atomicra1n/lab-power-supply/images/enclosure.png

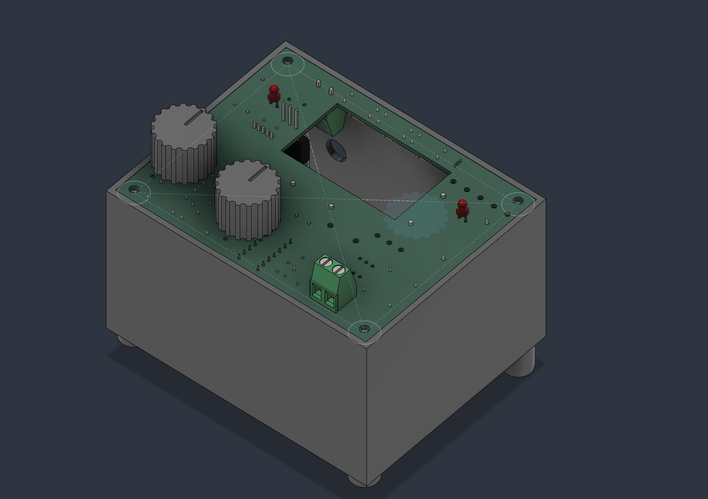
images/enclosure.png
