atomicra1n/lab-power-supply/images/pcb.png

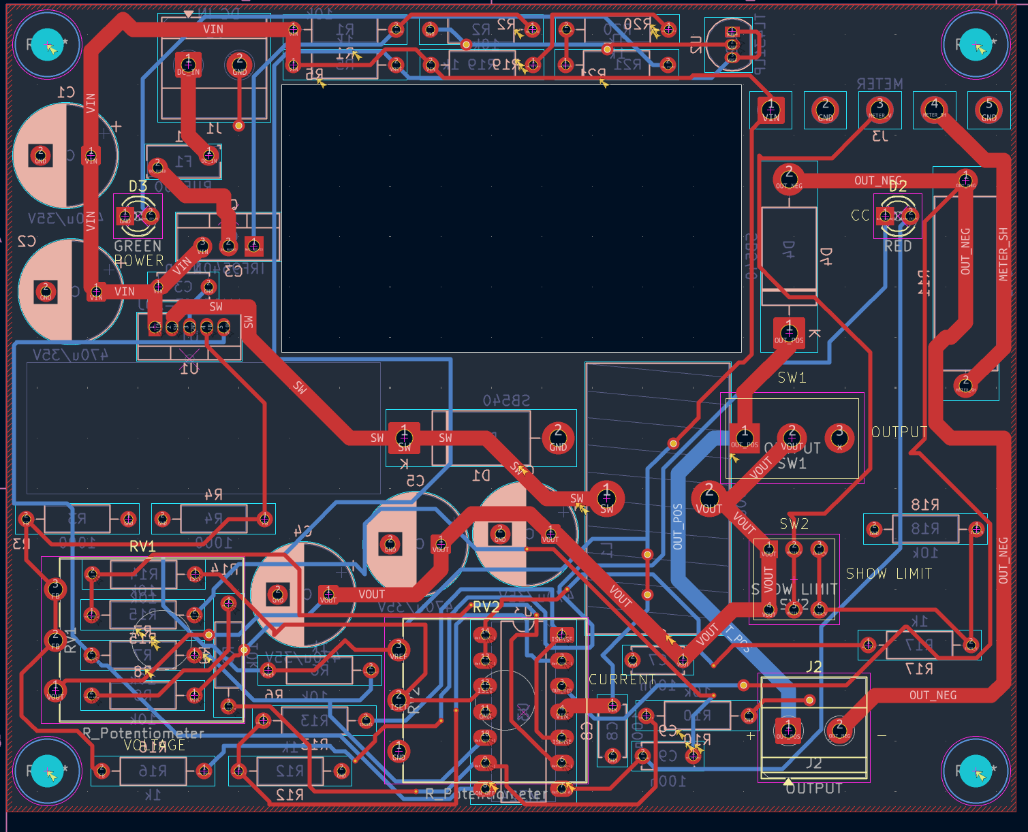
images/pcb.png
