atomicra1n/lab-power-supply/images/pcb_render_back.png

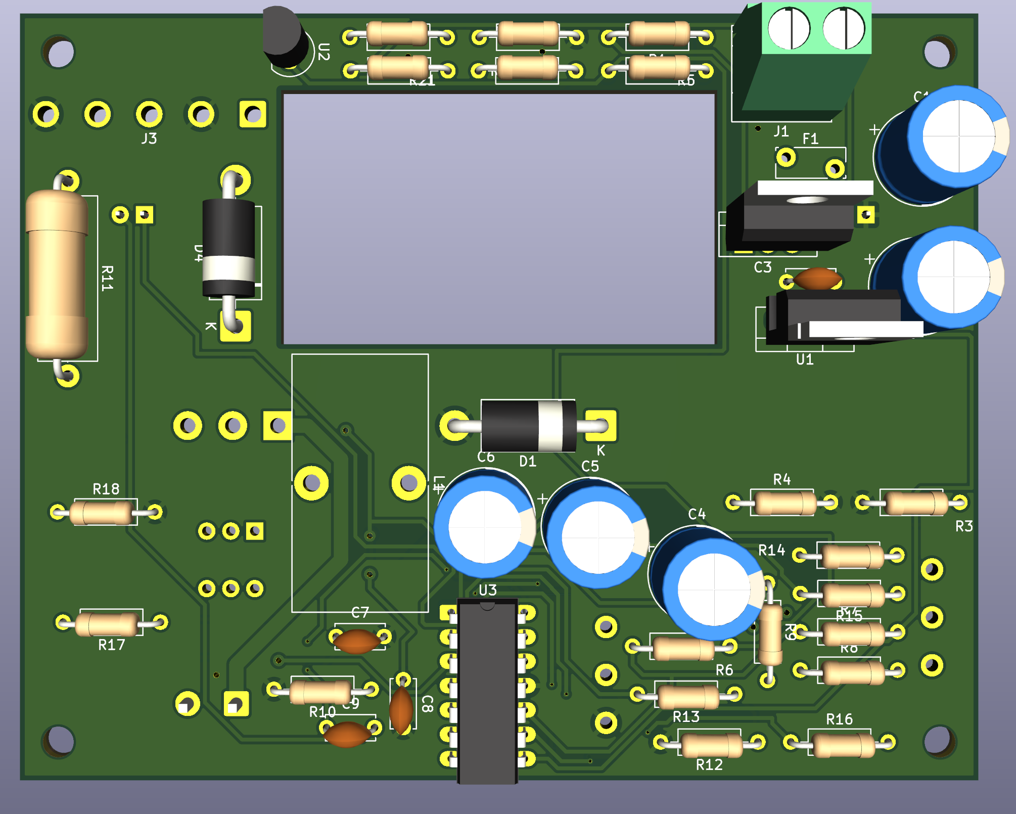
images/pcb_render_back.png
