atomicra1n/lab-power-supply/images/pcb_render_front.png

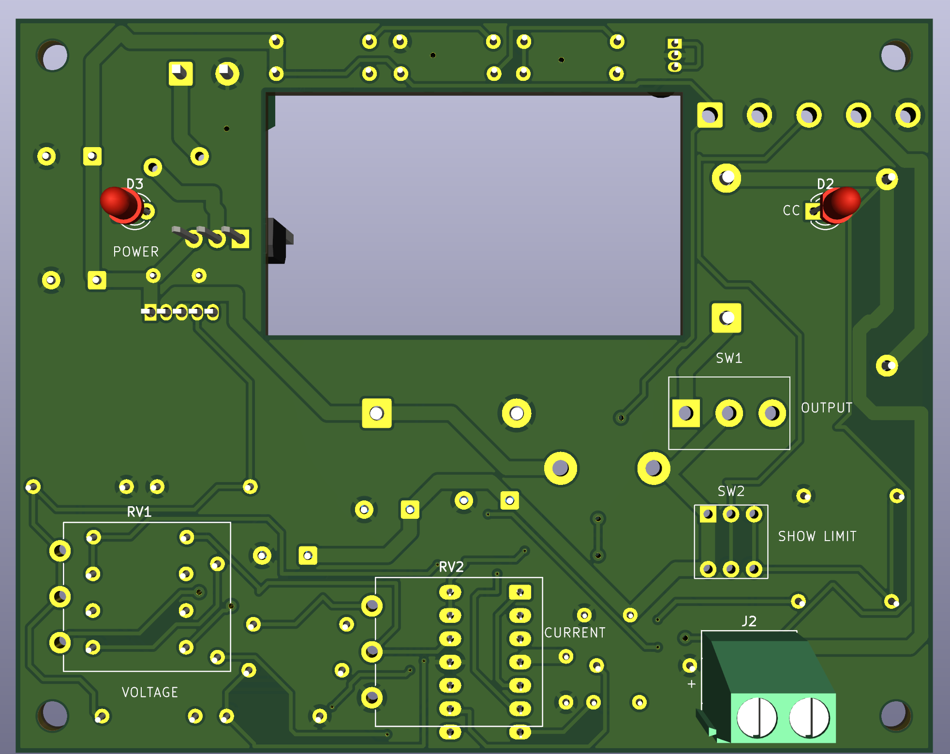
images/pcb_render_front.png
