atomicra1n/lab-power-supply/images/schematic.png

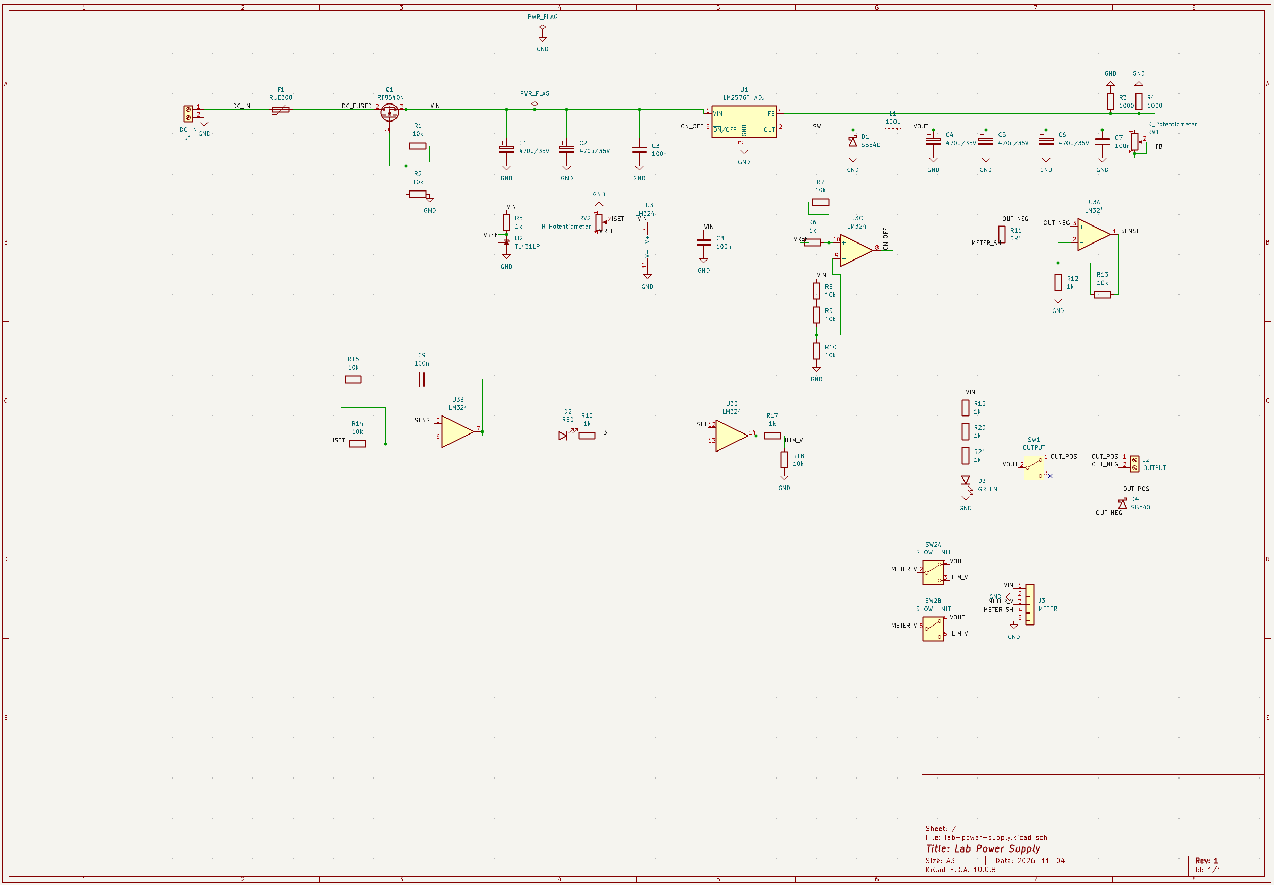
images/schematic.png
