atomicra1n/lab-power-supply/BOM.csv

Item | Qty | Supplier | Cost/item | Total Cost | link
TAEJIN-HTC LM2576T-ADJ | 1 | GM Electronic | $2.31 | $2.31 | https://www.gme.cz/v/1519044/taejin-htc-korea-lm2576t-adj-vykonovy-spinany-regulatorstep-down
TALEMA DPO-3.0-100 | 1 | GM Electronic | $3.07 | $3.07 | https://www.gme.cz/v/1494058/talema-dpo-30-100-tlumivka
SB540 YJ Schottky | 2 | GM Electronic | $0.45 | $0.90 | https://www.gme.cz/v/1514436/sb540-yj-schottkyho-dioda
V7143 BLACK heatsink | 1 | GM Electronic | $1.56 | $1.56 | https://www.gme.cz/v/1499787/v7143-black-chladic
INFINEON IRF9540NPBF | 1 | GM Electronic | $0.61 | $0.61 | https://www.gme.cz/v/1493222/infineon-irf9540npbf-unipolarni-tranzistor
TL431ACZ | 1 | GM Electronic | $0.28 | $0.28 | https://www.gme.cz/v/1493687/tl431acz
HITANO CE 470u/35V 10x16 | 5 | GM Electronic | $0.18 | $0.90 | https://www.gme.cz/v/1486880/hitano-ce-470u-35v-hit-ecr-10x16-rm5-bulk-elektrolyticky-kondenzator
CK 100n/50V X7R RM5,08 | 8 | GM Electronic | $0.09 | $0.72 | https://www.gme.cz/v/1520318/ck-100n-50v-x7r-rm508-10-keramicky-kondenzator
GYM/CYM RM 1k 0,6W 1% 0207 | 10 | GM Electronic | $0.09 | $0.90 | https://www.gme.cz/v/1486228/gym-cym-rm-1k-06w-1-0207-metalizovany-rezistor
GYM/CYM RM 10k 0,6W 1% 0207 | 10 | GM Electronic | $0.09 | $0.90 | https://www.gme.cz/v/1494150/gym-cym-rm-10k-06w-1-0207-metalizovany-rezistor
TEXAS INSTRUMENTS LM324N | 1 | GM Electronic | $0.42 | $0.42 | https://www.gme.cz/v/1490186/texas-instruments-lm324n
HITANO RD 0R1 3W 0617 | 4 | GM Electronic | $0.22 | $0.88 | https://www.gme.cz/v/1486965/hitano-rd-0r1-3w-5-0617-dratovy-rezistor
PC1623NBK010 10 kiloohm potentiometer | 2 | GM Electronic | $1.04 | $2.08 | https://www.gme.cz/v/1494596/pc1623nbk010-potenciometr
BRIGHT LED BL-B2141-L green | 1 | GM Electronic | $0.17 | $0.17 | https://www.gme.cz/v/1492964/bright-led-bl-b2141-l-led-3mm-zelena
BRIGHT LED BL-B5141-L red | 1 | GM Electronic | $0.17 | $0.17 | https://www.gme.cz/v/1492965/bright-led-bl-b5141-l-led-3mm-cervena
KLS 7-P8.0x8.0-0 button | 1 | GM Electronic | $0.25 | $0.25 | https://www.gme.cz/v/1500951/kls-7-p80x80-0-non-lock-tlacitko-do-dps-2-poly-onon
MTS-102-A2 toggle | 1 | GM Electronic | $0.66 | $0.66 | https://www.gme.cz/v/1501004/mts-102-a2-packovy-spinac
DEGSON DG301-5.0-02P | 2 | GM Electronic | $0.15 | $0.30 | https://www.gme.cz/v/1500295/degson-dg301-50-02p-13-00zh-svorkovnice-2pol-roztec-5mm-175a-250v-vstup-90-sroub
LITTELFUSE RUE300 | 1 | GM Electronic | $0.75 | $0.75 | https://www.gme.cz/v/1512378/littelfuse-rue300-vratna-pojistka-polyswitch
CREATALL CA-028-10A | 1 | GM Electronic | $3.73 | $3.73 | https://www.gme.cz/v/1518962/creatall-ca-028-10a-digitalni-panelovy-voltmetr-a-ampermetr
DS-026A DC jack 5.5/2.5 | 1 | GM Electronic | $1.04 | $1.04 | https://www.gme.cz/v/1498554/ds-026a-dc-konektor-55-25
WURTH SKM3X10 screw M3x10 | 5 | GM Electronic | $0.14 | $0.70 | https://www.gme.cz/v/1511747/wurth-skm3x10-ocelovy-sroub-m3x10mm-phillips-valcova-hlava-pozinkovany
WURTH SKM3K nut M3 | 1 | GM Electronic | $0.03 | $0.03 | https://www.gme.cz/v/1511808/wurth-skm3k-matice-m3
PCB manufacturing (5x) | 1 | JLCPCB | $4.00 | $4.00 | https://jlcpcb.com
Estimated total shipping | 1 |  |  | $11.00
