atomicra1n/lab-power-supply/cad/lab-power-supply-enclosure.step

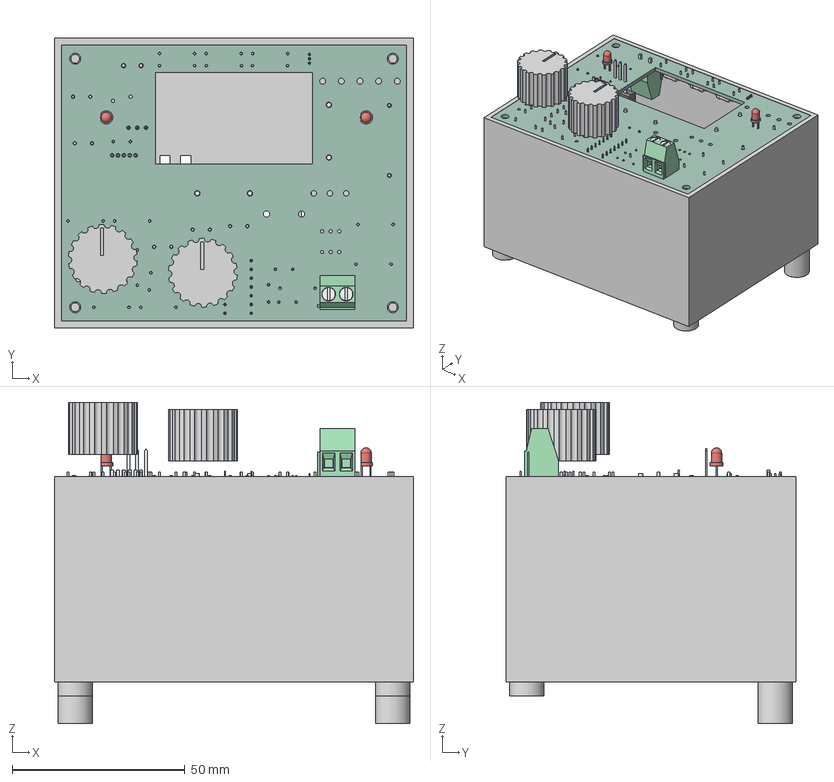
[picture p6: CAD file, 2026-11-07]
cad/lab-power-supply-enclosure.step
104.0 x 84.0 x 93.0 mm
