atomicra1n/lab-power-supply/stl/foot_12mm.stl

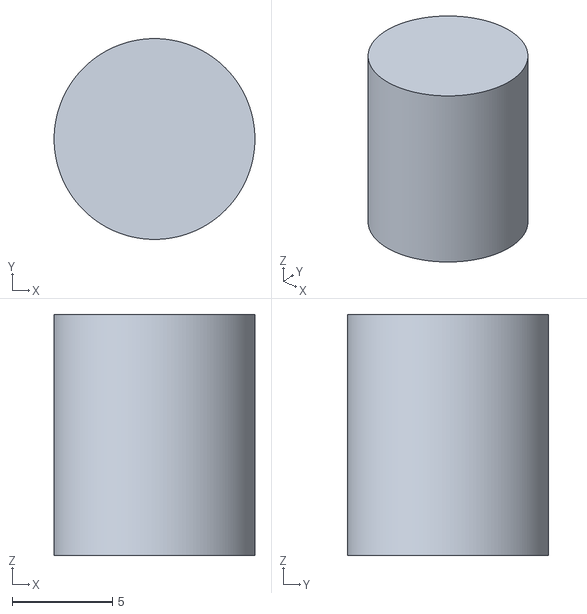
[picture p7: CAD file, 2026-11-07]
stl/foot_12mm.stl
10.00 x 10.00 x 12.0
