atomicra1n/lab-power-supply/stl/foot_4mm.stl

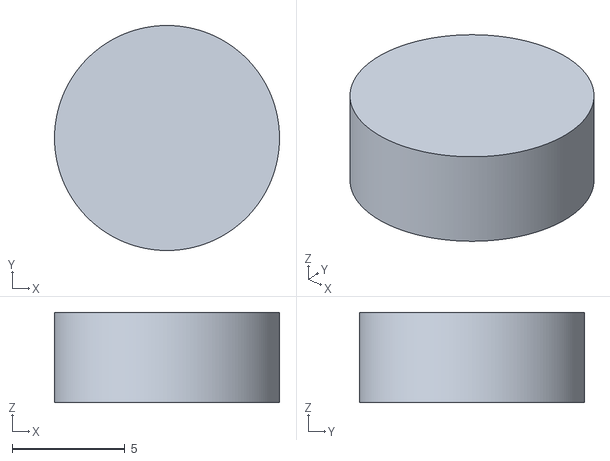
[picture p8: CAD file, 2026-11-07]
stl/foot_4mm.stl
10.0 x 10.0 x 4.00
