atomicra1n/lab-power-supply/stl/tray.stl

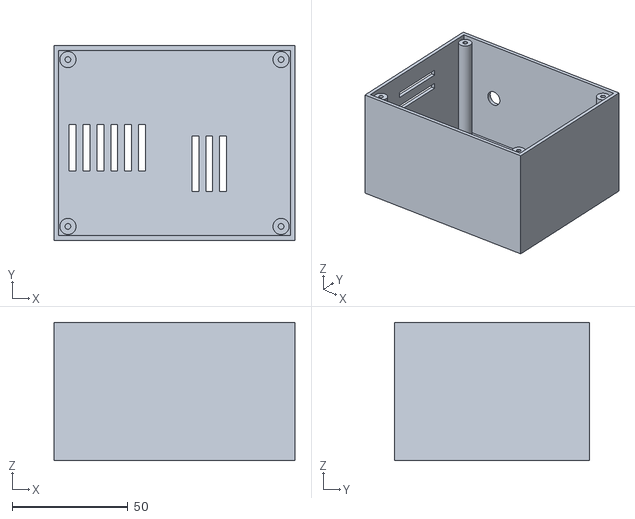
[picture p9: CAD file, 2026-11-07]
stl/tray.stl
104.0 x 84.0 x 59.6
