atomicra1n/lab-power-supply/stl/knob.stl

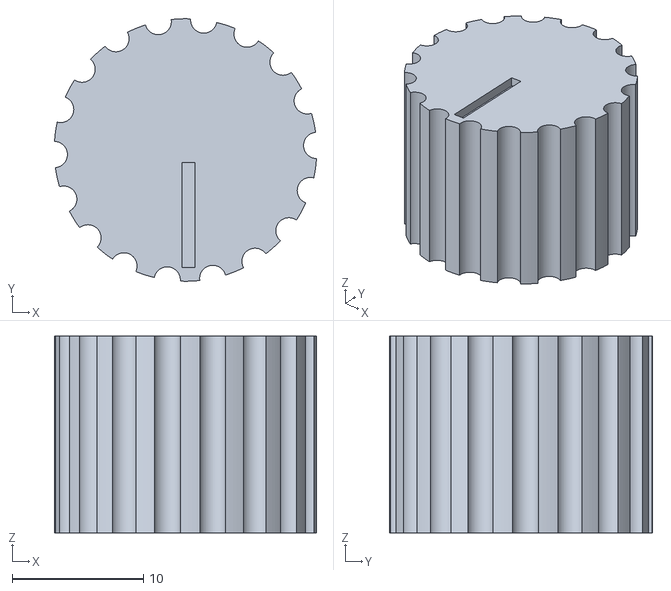
[picture p10: CAD file, 2026-11-07]
stl/knob.stl
20.0 x 20.0 x 15.0
