atomicra1n/lab-power-supply/(list of files, cad)

Other CAD files:
cad/lab-power-supply-enclosure.f3d
