atomicra1n/lab-power-supply/JOURNAL.md

# Lab Power Supply: devlog

<!-- Generated by Half Life from project vnvrcz1it7orpgph0o1aiyoc. Edits here are overwritten on the next sync. -->
<!-- Generated: 2026-11-07T19:35:36.796Z -->

> [!NOTE]
> This devlog is mirrored from [Half Life](https://halflife.hackclub.com) ([open the project](https://halflife.hackclub.com/projects/vnvrcz1it7orpgph0o1aiyoc)). Editing it here will not change the platform's copy, and the next sync overwrites this file.

> An adjustable power supply powered by a laptop charger. Has knobs for setting the voltage, current and a built-in meter for showing the output.

| Week | Tier | Hours logged | Entries |
| --- | --- | --- | --- |
| Week 5 | Tier 1 | 19h | 5 |

## Contents

1. [2026-11-05: # Nov 4: First work and schematic](#2026-11-05-nov-4-first-work-and-schematic)
2. [2026-11-05: # Nov 5: Finished schematic and footprints](#2026-11-05-nov-5-finished-schematic-and-footprints)
3. [2026-11-05: # Nov 5: Beginning PCB work](#2026-11-05-nov-5-beginning-pcb-work)
4. [2026-11-06: # Nov 6: Finishing the PCB](#2026-11-06-nov-6-finishing-the-pcb)
5. [2026-11-07: # Nov 7: CAD work](#2026-11-07-nov-7-cad-work)

## Design

### 2026-11-05: # Nov 4: First work and schematic

**4h**

# Nov 4: First work and schematic

Given that week 5 lets us build whatever we want, my brain immediately jumped to more nuclear related projects (I built some for week 1 and 4!), but then I reconsidered and thought - what would be genuinely useful to me?

I decided the answer was an adjustable power supply. It is a very handy thing to have for testing electronics or in general for work (I was recently reverse engineering a network switch and needed a  stable 3.3V source to dump the flash! Fun fact, a Raspberry Pi Pico can work, but it's amperage is very limited). First, I thought of how I would power said supply. I originally wanted USB, but it would get pricy and more complicated fast. So I decided to spare myself the pain and money and I found a Connect IT laptop charger that outputs around 18V on a 5.5/2.5mm barrel jack tip. I decided to use a LM2576T-ADJ buck converter to step it down while still being able to add current limiting that is adjustable. Given that lab supplies and their components are expensive, I decided this project would be fully analog with no microcontroller or firmware. That way, I can save money on the digital side of things and make the supply more powerful.

I started by going through GM Electronic (just like W3/4, it's my local electronics supplier) and picked out every part. The biggest issue like always is the fact that passive components have strict minimum order quantities, especially resistors (1 type of resistor = 10 pcs/2 Kč each, roughly 1$ total for 10). Resistors having a minimum would be bearable, but some components have a minimum much higher and the costs go up fast. I decided I would only use 1k and 10k resistors to save money on other types.

GM Electronic cart

One feature I was planning was undervoltage lockout to make sure that the regulator wouldn't try to run with an input too low. My original idea was using a TL431  as a comparator that would drive the ON and OFF pins of LM2576, but the datasheet of LM2576 sadly clearly says the ON and OFF pin needed to be below 1 volt for the regulator to turn on, and the TL431 can never get its cathode below 2V. To fix this, I removed the LM358P I originally planned for sensing current and replaced it with an LM324N.

With parts picked out and an idea of how the supply would work, I created the KiCad project, made a repo, structured it and started the schematic. For the input stage, I put a simple screw terminal from the DC jack, a RUE300 polyfuse for OCP and I also added reverse polarity protection (w/ IRF9540N).

Input

Next I put a LM2576T-ADJ buck converter. I used a TALEMA DPO-3.0-100 inductor and a SB540 Schottky catch diode. I needed a 500 ohm resistance for feedback, so I had to make it in parallel using my two 1k resistors. For undervoltage lockout, I used the C variant of the LM324 op-amp. Below about 7.5V, the comparator output goes HIGH and the regulator is turned off. I added slight hysteresis (a 10k resistor) which gives a turn on about 8.8V and turn off at 6.8 volts.

Buck section

Under voltage lockout section

**Next up: Finishing the schematic and assigning footprints.**

**tl;dr: Planned the project, picked all parts, drew the input section, buck converter, undervoltage lockout, added hysteresis**

**Total time spent: ~4 hours**

### 2026-11-05: # Nov 5: Finished schematic and footprints

**5h**

# Nov 5: Finished schematic and footprints

Today I continued where yesterday's work ended, which was still the schematic. First thing to make today was current sensing. I used a 0.1 ohm 3 watt shunt resistor on the output return path and used an op-amp (variant A this time) as a sense amplifier which ended up giving around 1.1V for each ampere. The limit is set by the current potentiometer and sensed current is compared against the setpoint by op-amp variant B. We also use a red LED to show CC mode, but it also blocks current from flowing backwards into the feedback. I originally tried using an SB540 diode but it could possibly leak a bit of current backwards which wouldn't be ideal for my project.

Current sensing and CC loop part 1

Current sensing and CC loop part 2

Op-amp variant D is used for buffering the SHOW LIMIT voltage. When the button is pressed, the meter reads the setpoint scaled in a way that 1.00V on our display means 1.00A limit. It's a bit finnicky but it was the best way to avoid paying for another display. However, here came a bigger issue! I originally picked a 1k resistor from VIN to the LED, but after checking the listing of my [LED](https://www.gme.cz/v/1492964/bright-led-bl-b2141-l-led-3mm-zelena), I found out the maximum forward current was only 7 mA, and we would easily exceed that with 18V and a 1k resistor. So I changed it to three 1k resistors in a series which should be enough.

Fixed green LED

When wiring the front panel, I used the MTS-102-A2 toggle switch in the output line after the voltage sense point of the meter, which means I can easily set the voltage with the output disconnected and the meter would still show it. For the SHOW LIMIT button, I added a KLS 7-P8.0x8.0 DPDT momentary button. I also added a SB540 diode for reverse protection across the output terminal.

After I was done with the schematic, I ran the electrical rules checker and got two warnings. KiCad unfortunately made the second half of the DPDT button into a separate part (SW3) instead of being the B of SW2, so I had to change the reference manually.

ERC warnings

ERC clean

Assigning footprints was as always a bit tedious. Most parts were standard KiCad footprints (but of course I still had to assign them), but two parts had no footprints. The MTS-102-A2 toggle and the KLS7 button. I had to make a custom footprint for those, but thankfully I had a good amount of practice with that from week 3 and 4!

Unassigned footprints

Assigned footprints

Custom footprint for the MTS-102 toggle

Custom footprint for the KLS7 button

**Next up: Beginning PCB work.**

**tl;dr: Finished the full schematic with current sensing, CC loop, SHOW LIMIT, LEDs, output, meter), fixed overcurrent on an LED, assigned all footprints, made two custom footprints, cleaned ERC.**

**Total time spent: ~5 hours**

### 2026-11-05: # Nov 5: Beginning PCB work

**2h**

# Nov 5: Beginning PCB work

After I finished the schematic and footprints, I was able to finally get started in the PCB editor. First, I drew the outline (100x80mm) and I cut a hole near the top to clip the meter (which will show volts/amps). I originally made it unnecessarily large and wasn't able to fit most components, but I revised the scale and noticed it was *way* too big. Afterwards, I placed the front side components. Just like week 4, this was another project where I would need both sides of the PCB. I placed two potentiometers, the toggle switch and the SHOW limit button. I also placed the output terminal and LEDs. The front was way easier than the back, but while placing the potentiometers, **I noticed the knob was wired backwards in the schematic.** I put pin 3 on GND, but usually, turning clockwise moves the wiper of the pot towards pin 3. This would mean that clockwise turning would lower the limit. I swapped the two end pins and updated the PCB, it wouldn't be a huge issue but it would be an unfortunate mistake to make.

For the remaining parts, I flipped them all to the back and began placing. The power paths went in the top left and I drew a rectangle to reserve space for a heatsink behind U1, as I suspect the component may grow a bit hotter. All in all, it took a lot of scrambling but I placed all the components eventually. I had to place some components below the front layer pots, but that should be alright as long as I'm careful during build week.

Placed components

Front of the 3D PCB

Back of the 3D PCB

**Next up: Routing, ground pour**

**tl;dr: Drew the PCB outline, placed all front and back components, made space for the heatsink**

**Total time spent: ~2 hours**

### 2026-11-06: # Nov 6: Finishing the PCB

**4h**

# Nov 6: Finishing the PCB

Today I got the PCB done. First, I setup track widths (1.5mm for power and 0.4mm for the rest), but I quickly ran into issues with the wider tracks, as they wouldn't fit in tighter places and there wasn't much of an easy way to route around it. This was mainly the issue for the VIN net, I had to route the main trunk at 1.5 milimeters and the smaller branches kept at 0.4mm which let them reach in harder to reach spots.

Routing is genuinely not pretty, but I believe it should work, just like every week! An issue I ran into was the current sensing. Originally, I put the U3's sense input connected to the OUT_NEG track near the output terminal, but that would add a good amount of resistance from the copper itself, and inflate the reading. So I rerouted it as a thin 0.4mm wire directly to R11, decreasing the amount of steps, hopefully making the reading more accurate.

Routed board

After routing was done, it was time for the ground pour. I made it on both layers, filled it. DRC had quite a few issues this time, unlike my week 4 project which came out surprisingly clean. The ground pin of U1 had only one thermal spoke connecting it to the GND fill, so I added a short wide track from its ground to C3 ground and set both pads to solid fill, changing it from thermal relief. I also had to clean up some leftover vias and tracks.

Routed board with the ground pour

After DRC was clean, I exported Gerbers, drill files and got a JLCPCB quote. Again, 5 boards came out to 15$ with shipping! Not bad!

JLCPCB Quote

Front render

Back render

**Next up: CAD**

**tl;dr: Routed the entire PCB, finishing it. Fixed a problem with current sensing, added GND pour, cleaned DRC, exported Gerbers**

**Total time spent: ~4 hours**

### 2026-11-07: # Nov 7: CAD work

**4h**

# Nov 7: CAD work

Today it was time to do one final stretch and finish the project in CAD. I worked in Autodesk Fusion and started by importing the STEP file of my PCB from KiCad. I wanted to make a basic enclosure (similar to that what I made in Week 4). The board is meant to sit in the opening of the case (basically like a lid) and screw into the four corners. Our board features a heatsink (for the LM2576) which is 50mm tall, and that is the biggest challenge for the enclosure. Not only does it need to be deep enough with some clearance, but we also need to keep heat dissipation in mind.

To make sure that I do not cause issues with the heatsink, I firstly made a 35x12x50mm block where LM2576 would sit and kept it there for the whole build, mostly so I can check interference. The tray was a box with 2mm thick walls emptied using the shell tool. I also added four posts in corners with 2.5mm holes for screws that will hold the PCB in place.

PCB on the tray

Placeholder heatsink for interference avoiding

The first big mistake I did was building the tray on the wrong side of the board, as I extruded it towards the front (where the knobs sit) instead of the back (with the components and heatsink). This meant that at most, the user could play with the electrical components and never interact with the electrical outputs and with the input knobs. Not great! I had to go back in the timeline and flip the direction of extruding the tray, posts and screw holes.

View with hidden PCB, screw holes visible

Next, heat dissipation. I added some ventilation holes to make sure air can get in and out. I put 9 holes in the floor of the tray and some slots in the side to let air escape better. I ran into some trouble here too, accidentally swapping dimensions and making them vertical instead of horizontal, which wasn't as big of an issue as before but still I fixed it. To fix it, I just had to swap the numbers.

For the DC jack, I made an 8mm hole. I couldn't find the exact hole size for the DS-026A (from GM Electronic) on the website, so I had to go with 8mm for now and the hole can be expanded during build week if needed.

I also made feet, with the feet in the back being 12mm tall and frontal ones being 4mm tall. That tilts the panel a bit, but I realized it would be a bit hard to print the tray with the feet, so I had to separate them into separate bodies for printing. Knobs were pretty nice to make, just simple cylinders that are 15 milimeters tall and have 18 grooves for an easier grip. I also made it a separate export just like the feet.

Feet, bottom holes and jack hole

Custom knob

PCB with finished enclosure and one knob

Interference came out clean at the end, so I exported all STLs (tray, knob, two pairs of feet) and exported the .step and f3d files. All seemed to check out.

**Next up: Final submission**

**tl;dr: Built the full enclosure in Fusion (tray + vents, DC jack hole, feet with tilt, grippable knobs, ran into issues with extruding on wrong sides and swapping axis, exported all STLs and CAD files.**

**Total time spent: ~4 hours**
