atomicra1n/lab-power-supply/pcb/lab-power-supply.kicad_pcb

## KiCad design pcb/lab-power-supply.kicad_pcb (2026-11-07)

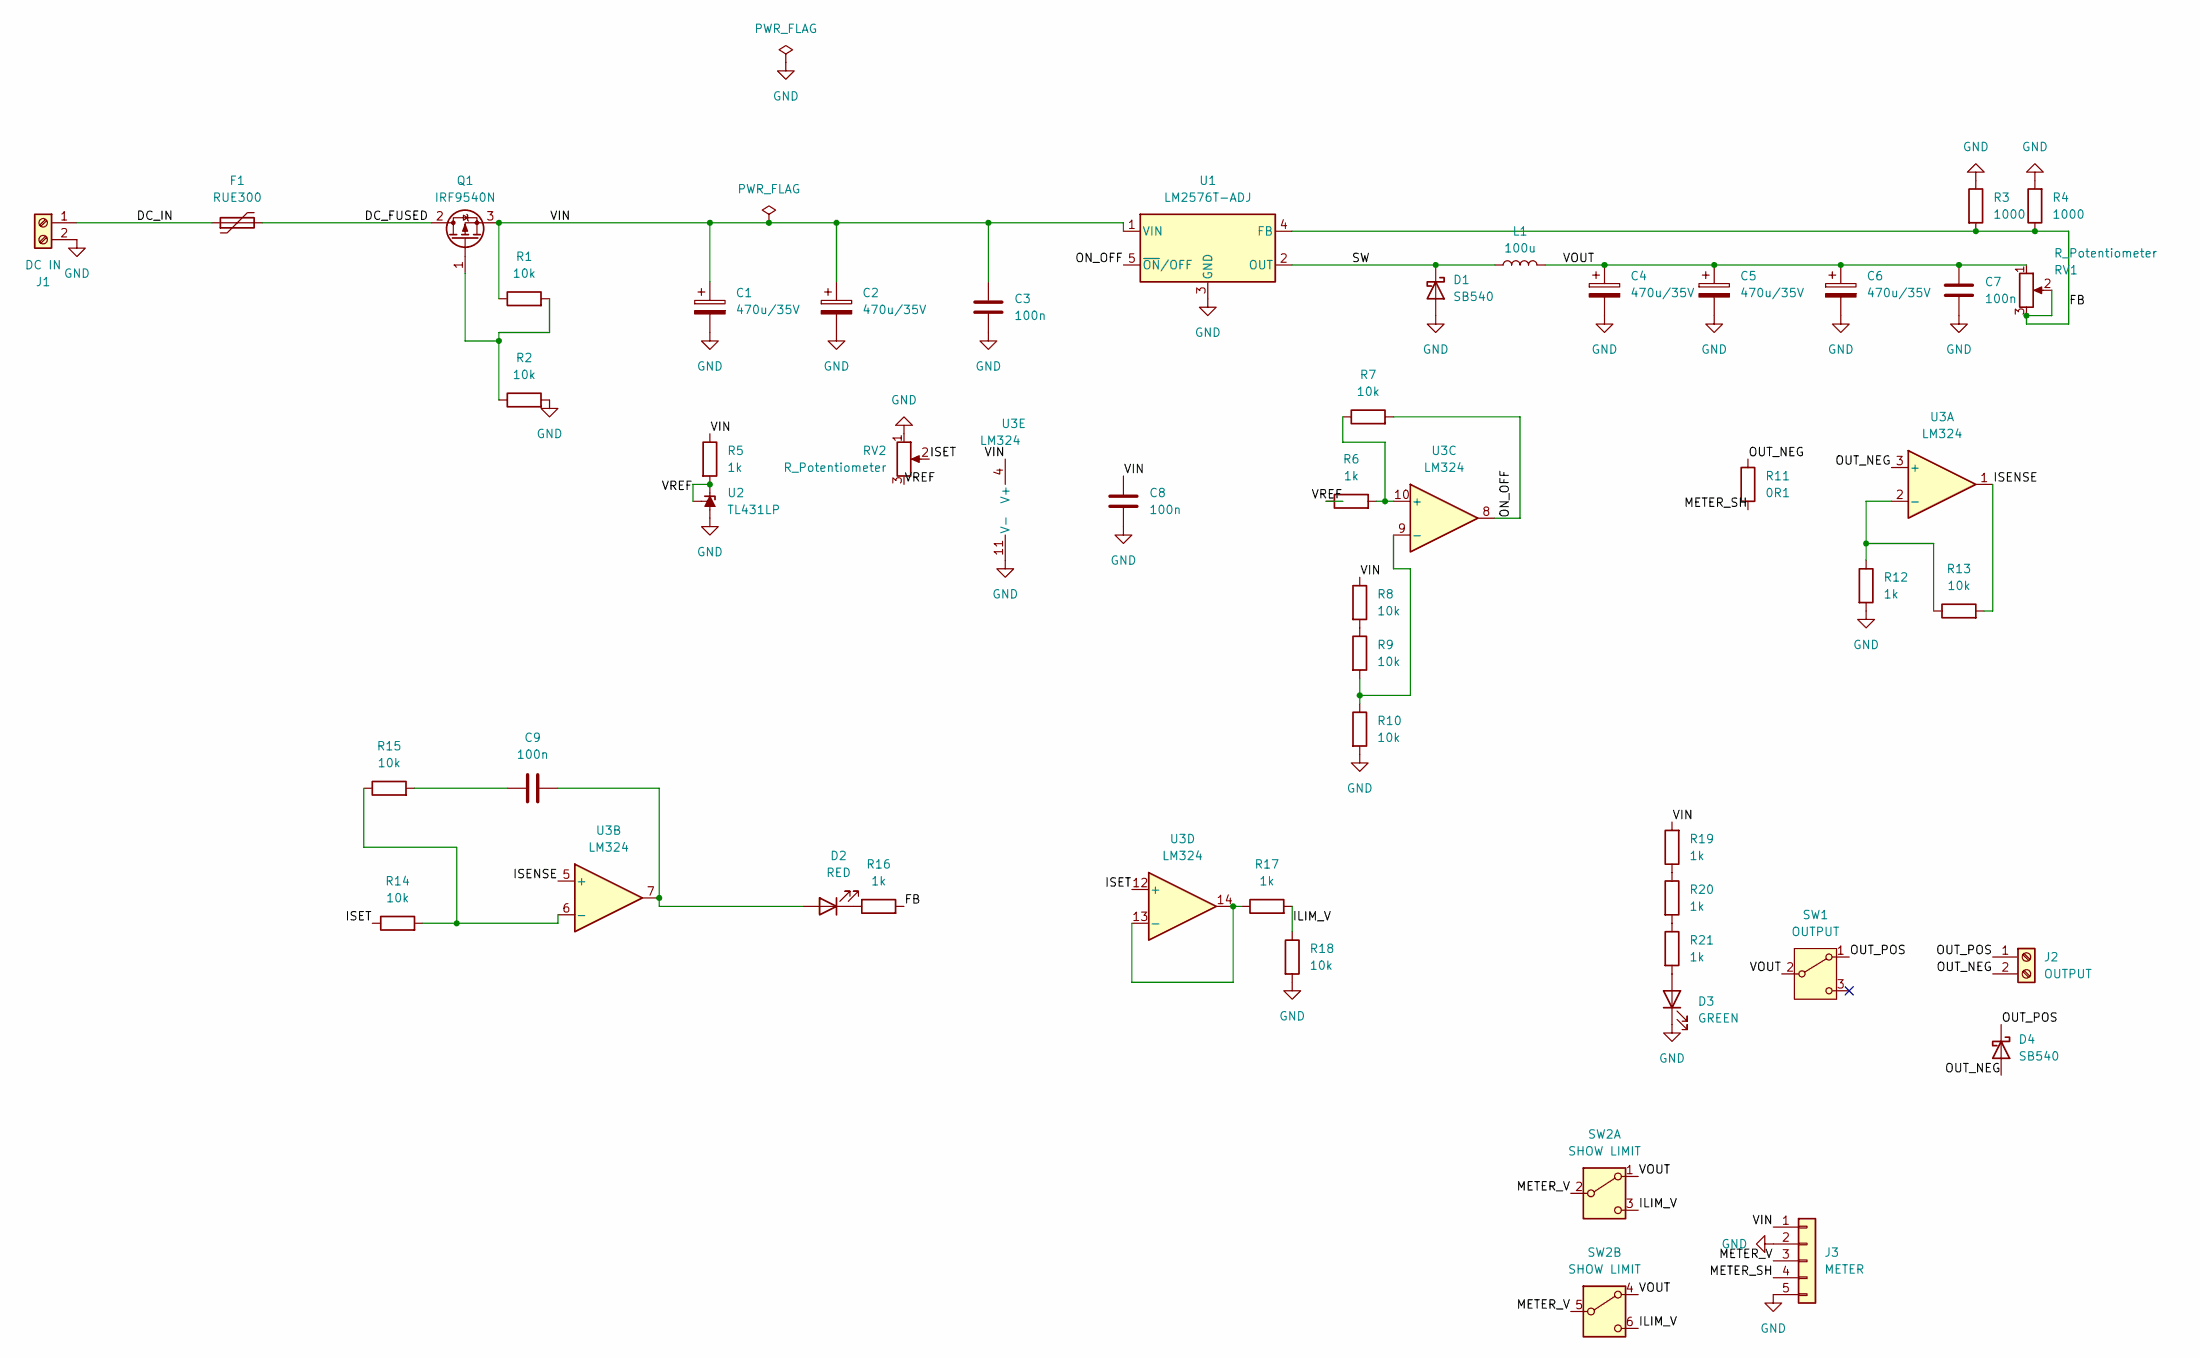
[picture p11: schematic lab-power-supply.kicad_sch, Lab Power Supply]

Parts:
C1, C2, C4, C5, C6: 470u/35V; CP_Radial_D10.0mm_P5.00mm
C3, C7, C8, C9: 100n; C_Disc_D5.0mm_W2.5mm_P5.00mm
D1, D4: SB540; D_DO-201AD_P15.24mm_Horizontal
D2: RED; LED_D3.0mm
D3: GREEN; LED_D3.0mm
F1: RUE300; Fuse_Bourns_MF-RG300
J1: DC IN; TerminalBlock_Phoenix_MKDS-1,5-2-5.08_1x02_P5.08mm_Horizont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
J2: OUTPUT; TerminalBlock_Phoenix_MKDS-1,5-2-5.08_1x02_P5.08mm_Horizont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
J3: METER; SolderWire-1sqmm_1x05_P5.4mm_D1.4mm_OD2.7mm
L1: 100u; L_Toroid_Vertical_L26.7mm_W14.0mm_P10.16mm_Pulse_D
Q1: IRF9540N; TO-220-3_Vertical
R1, R2, R7, R8, R9, R10, R13, R14, R15, R18: 10k; R_Axial_DIN0207_L6.3mm_D2.5mm_P10.16mm_Horizontal
R3, R4: 1000; R_Axial_DIN0207_L6.3mm_D2.5mm_P10.16mm_Horizontal
R5, R6, R12, R16, R17, R19, R20, R21: 1k; R_Axial_DIN0207_L6.3mm_D2.5mm_P10.16mm_Horizontal
R11: 0R1; R_Axial_DIN0617_L17.0mm_D6.0mm_P20.32mm_Horizontal
RV1, RV2: R_Potentiometer; Potentiometer_Piher_PC-16_Single_Vertical
SW1: OUTPUT; SW_MTS-102-A2
SW2: SHOW LIMIT; SW_KLS7-P8.0x8.0
U1: LM2576T-ADJ; TO-220-5_Vertical
U2: TL431LP; TO-92_Inline
U3: LM324; DIP-14_W7.62mm_LongPads

Connections:
/DC_FUSED: F1.2, Q1.2 (D)
/DC_IN: F1.1, J1.1
/FB: R3.2, R4.1, R16.2, RV1.2, RV1.3, U1.4 (FB)
/ILIM_V: R17.2, R18.1, SW2.3 (C), SW2.6 (C)
/ISENSE: R13.2, U3.1, U3.5 (+)
/ISET: R14.1, RV2.2, U3.12 (+)
/METER_SH: J3.4, R11.2
/METER_V: J3.3, SW2.2 (B), SW2.5 (B)
/ON_OFF: R7.2, U1.5 (~ON/OFF), U3.8
/OUT_NEG: D4.2 (A), J2.2, R11.1, U3.3 (+)
/OUT_POS: D4.1 (K), J2.1, SW1.1 (A)
/SW: D1.1 (K), L1.1, U1.2 (OUT)
/VIN: C1.1, C2.1, C3.1, C8.1, J3.1, Q1.3 (S), R1.1, R5.1, R8.1, R19.2, U1.1 (VIN), U3.4 (V+)
/VOUT: C4.1, C5.1, C6.1, C7.1, L1.2, RV1.1, SW1.2 (B), SW2.1 (A), SW2.4 (A)
/VREF: R5.2, R6.1, RV2.3, U2.1 (REF), U2.3 (K)
GND: C1.2, C2.2, C3.2, C4.2, C5.2, C6.2, C7.2, C8.2, D1.2 (A), D3.1 (K), J1.2, J3.2, J3.5, R2.2, R3.1, R4.2, R10.2, R12.2, R18.2, RV2.1, U1.3 (GND), U2.2 (A), U3.11 (V-)
unnamed: C9.1, R15.2
unnamed: C9.2, D2.2 (A), U3.7
unnamed: D2.1 (K), R16.1
unnamed: D3.2 (A), R21.2
unnamed: Q1.1 (G), R1.2, R2.1
unnamed: R8.2, R9.1
unnamed: R19.1, R20.1
unnamed: R20.2, R21.1
unnamed: R12.1, R13.1, U3.2 (-)
unnamed: R14.2, R15.1, U3.6 (-)
unnamed: R6.2, R7.1, U3.10 (+)
unnamed: R9.2, R10.1, U3.9 (-)
unnamed: R17.1, U3.13 (-), U3.14

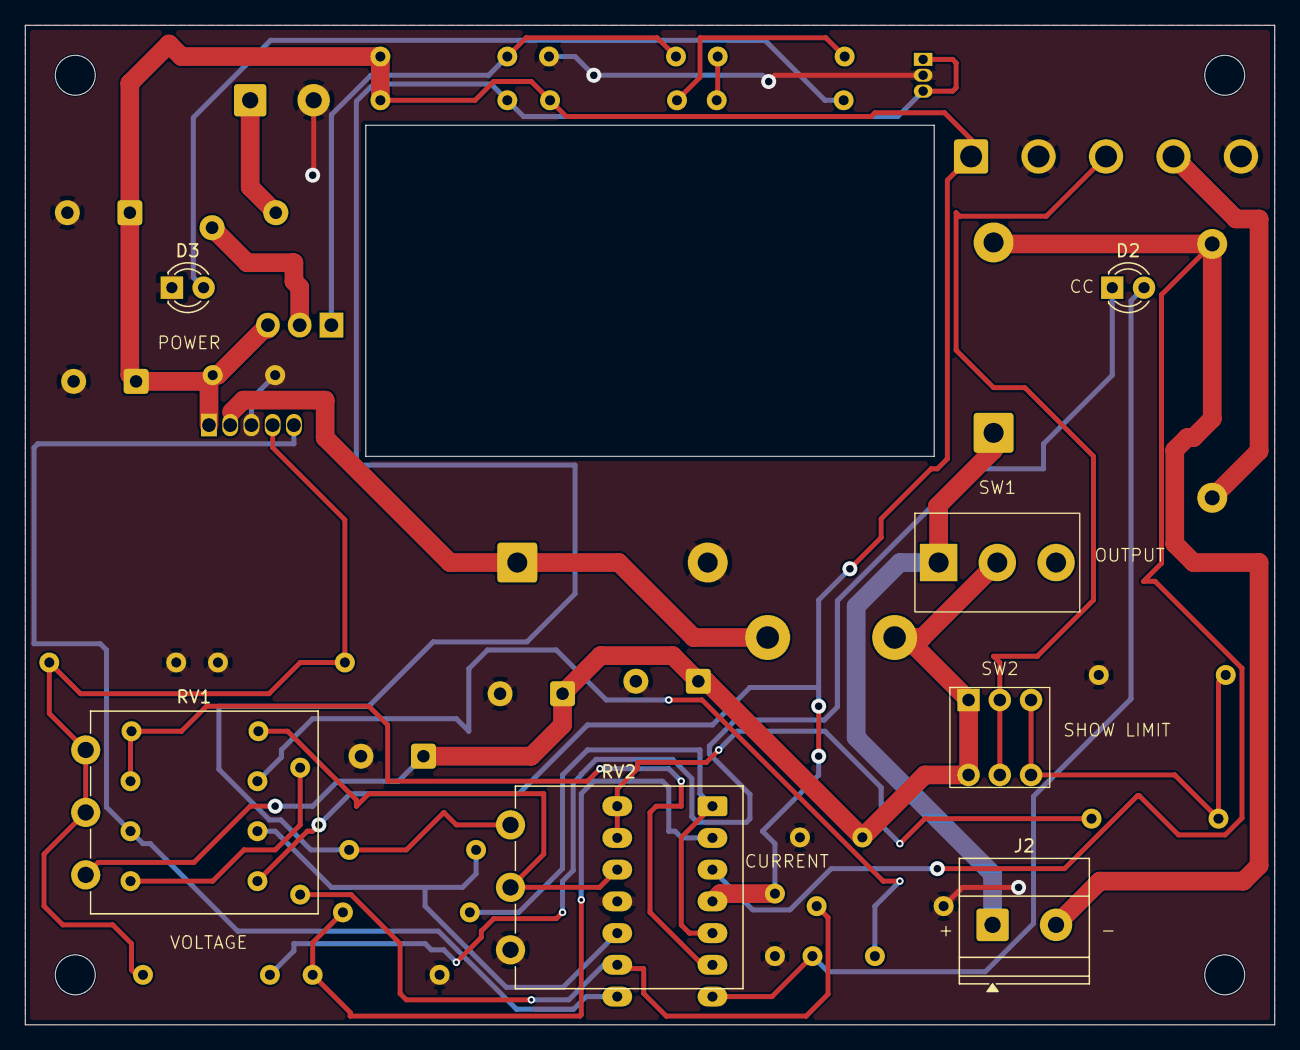
[picture p12: board lab-power-supply.kicad_pcb from above]

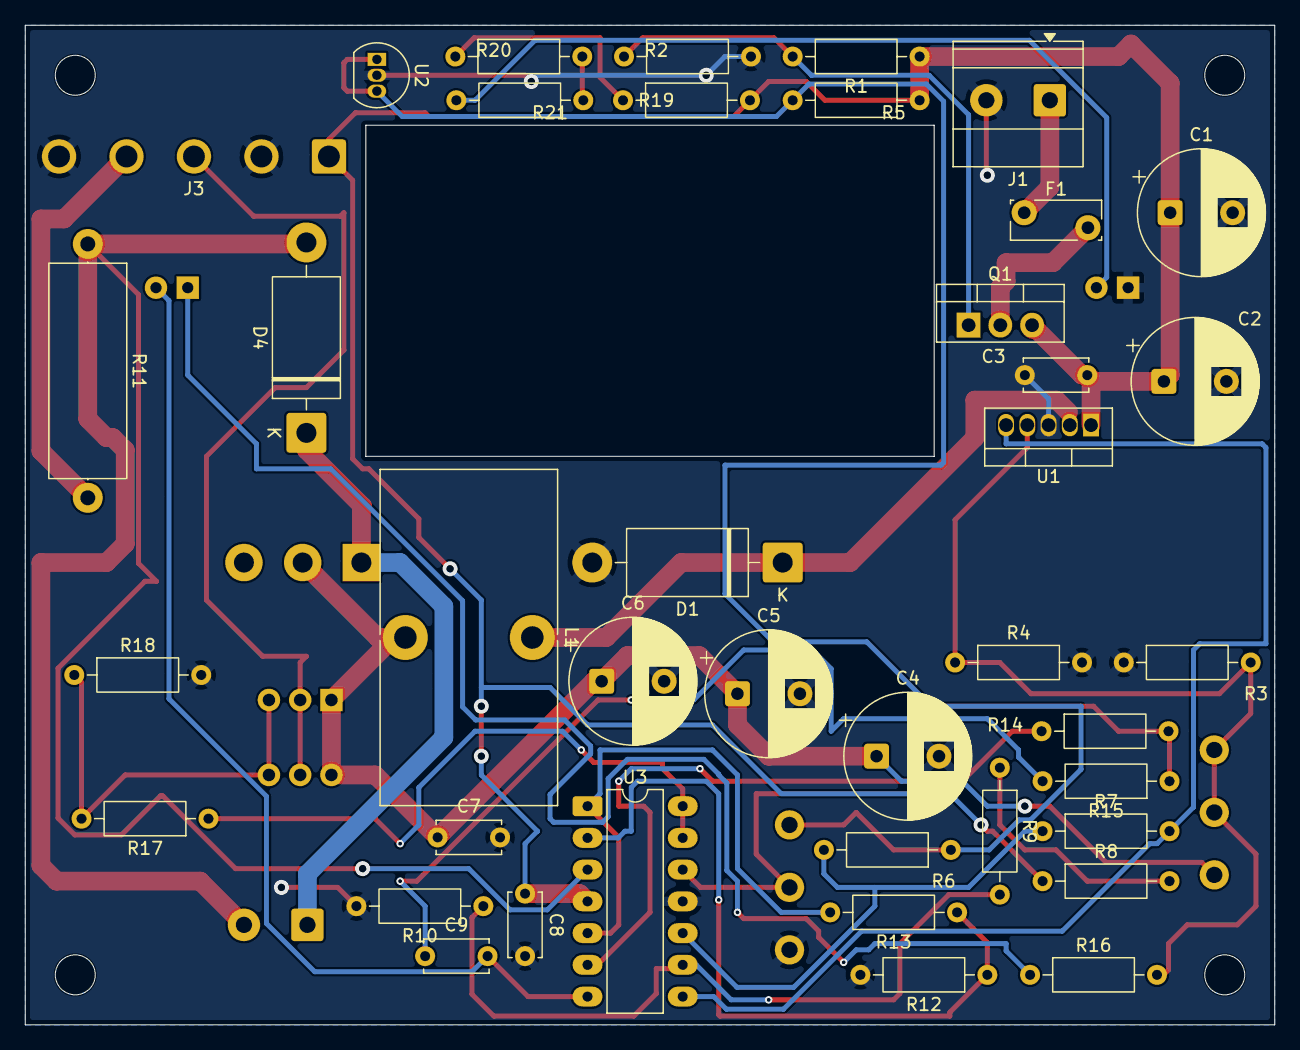
[picture p13: board lab-power-supply.kicad_pcb from below]

Board: 2 copper layers, 100.0 x 80.0 mm, 47 parts (40 on the bottom side), 29 nets.
