atomicra1n/lab-power-supply/(commit log)

2026-11-03 Sync Lab Power Supply from Half Life
    [BOM.csv]
2026-11-05 schematic, footprints, begin pcb work
    [lab-power-supply.kicad_pcb, lab-power-supply.kicad_sch]
2026-11-06 finish routing
    [lab-power-supply.kicad_pcb]
2026-11-07 finish CAD work
    [foot_12mm.stl, foot_4mm.stl, knob.stl, lab-power-supply-enclosure.f3d, lab-power-supply-enclosure.step, tray.stl]
